solderparty/keyboard_featherwing_pico_adapter/schematics.pdf

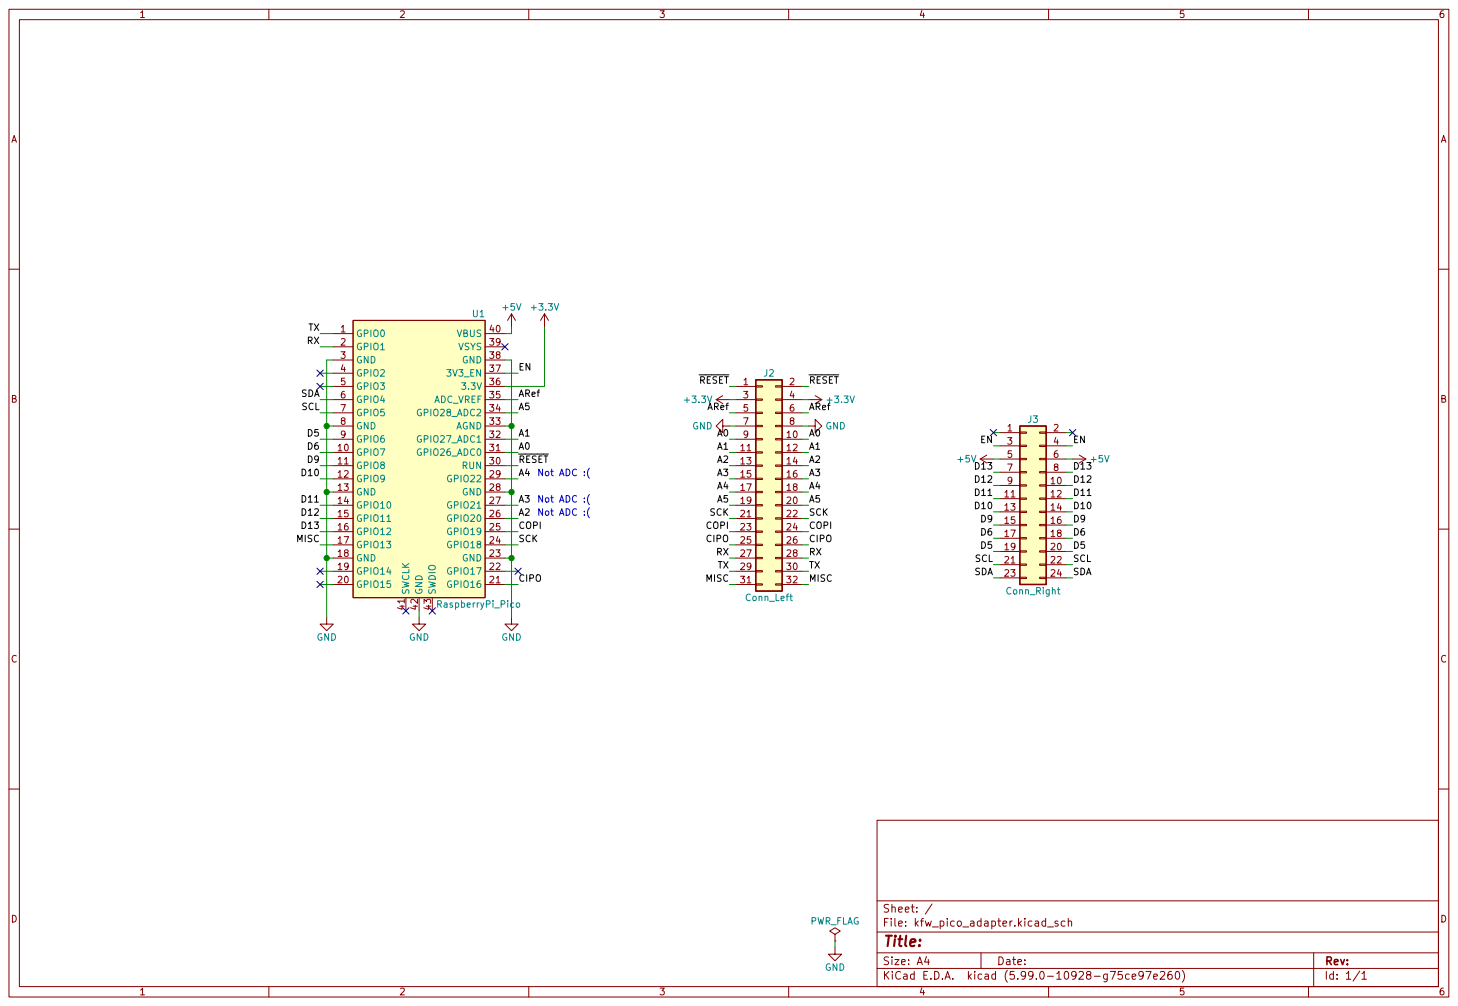
[picture p2: page 1]
