solderparty/keyboard_featherwing_pico_adapter/(commit log)

2021-06-29 Initial import
    [kfw_pico_adapter.kicad_pcb, kfw_pico_adapter.kicad_sch]
2021-08-16 Connect the BAT pins together
    [kfw_pico_adapter.kicad_pcb, kfw_pico_adapter.kicad_sch]
2021-09-17 Update the date to show new rev
    [kfw_pico_adapter.kicad_pcb]
